obdevel/Pico-hardware/IMG_0175.JPG

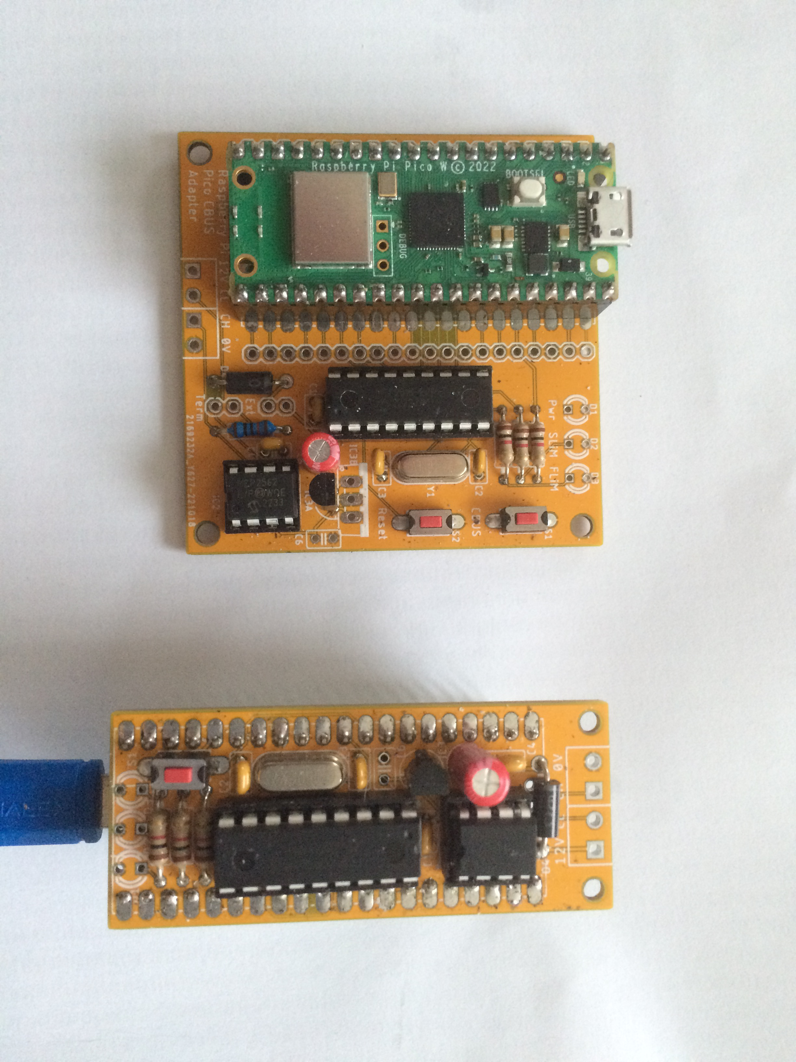
IMG_0175.JPG
