obdevel/Pico-hardware/CBUS Pico TH adapter rev A.png

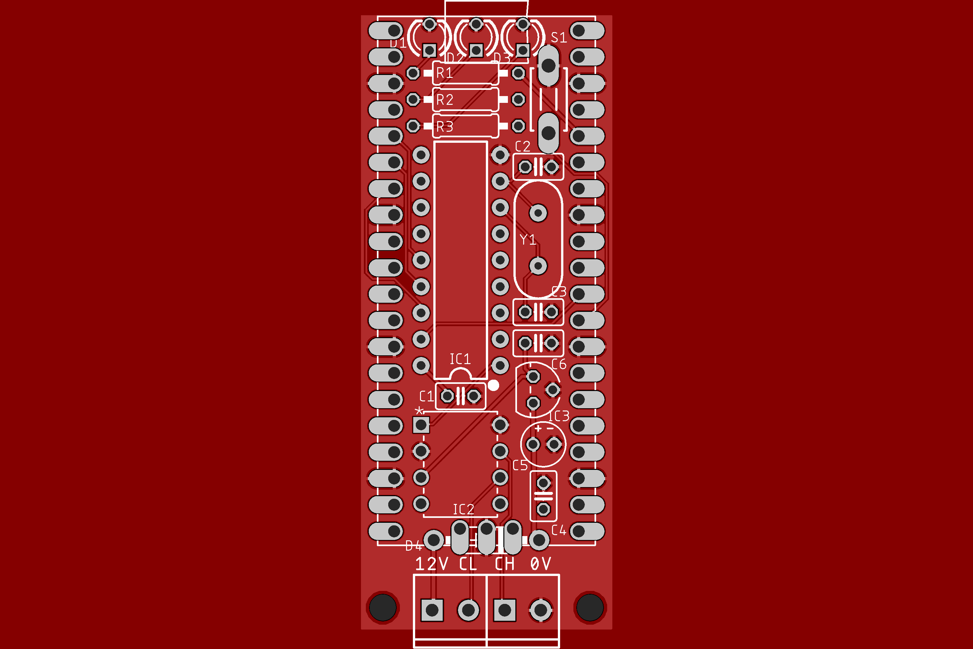
CBUS Pico TH adapter rev A.png
