obdevel/Pico-hardware/CBUS Pico TH adapter rev A.pdf

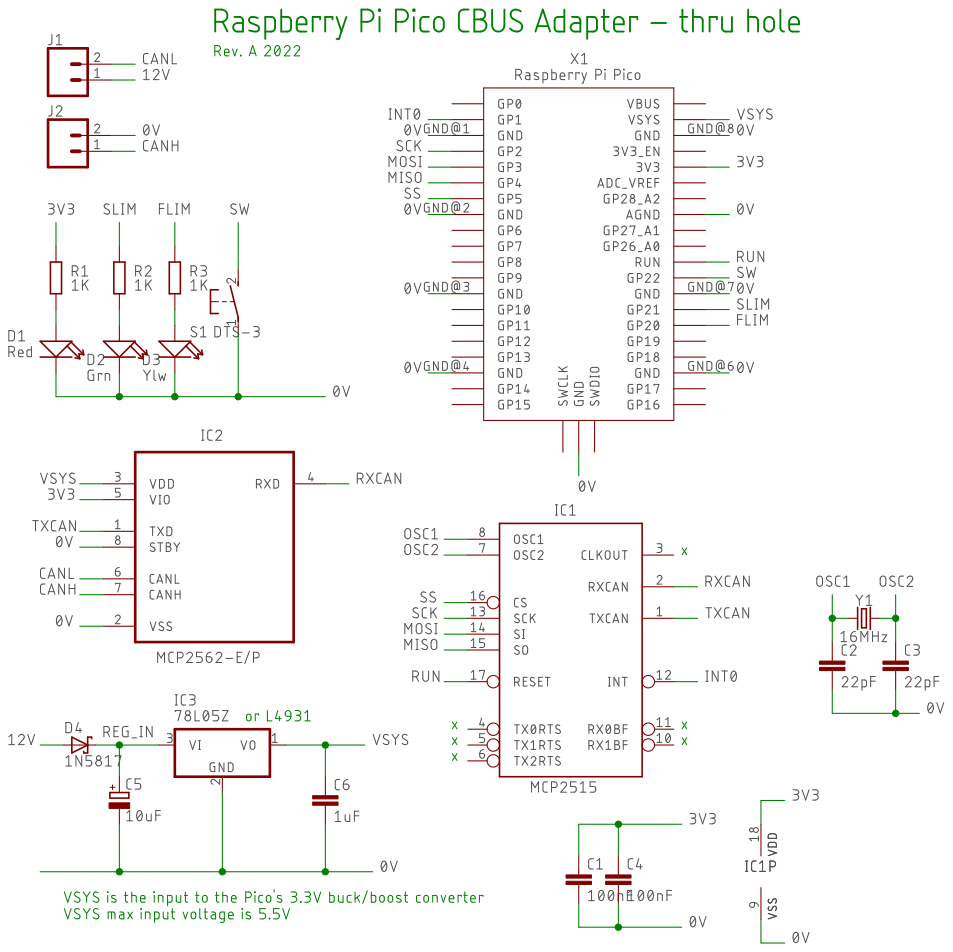
[picture p3: page 1]
