obdevel/Pico-hardware/CBUS Pico TH carrier w headers rev A.pdf

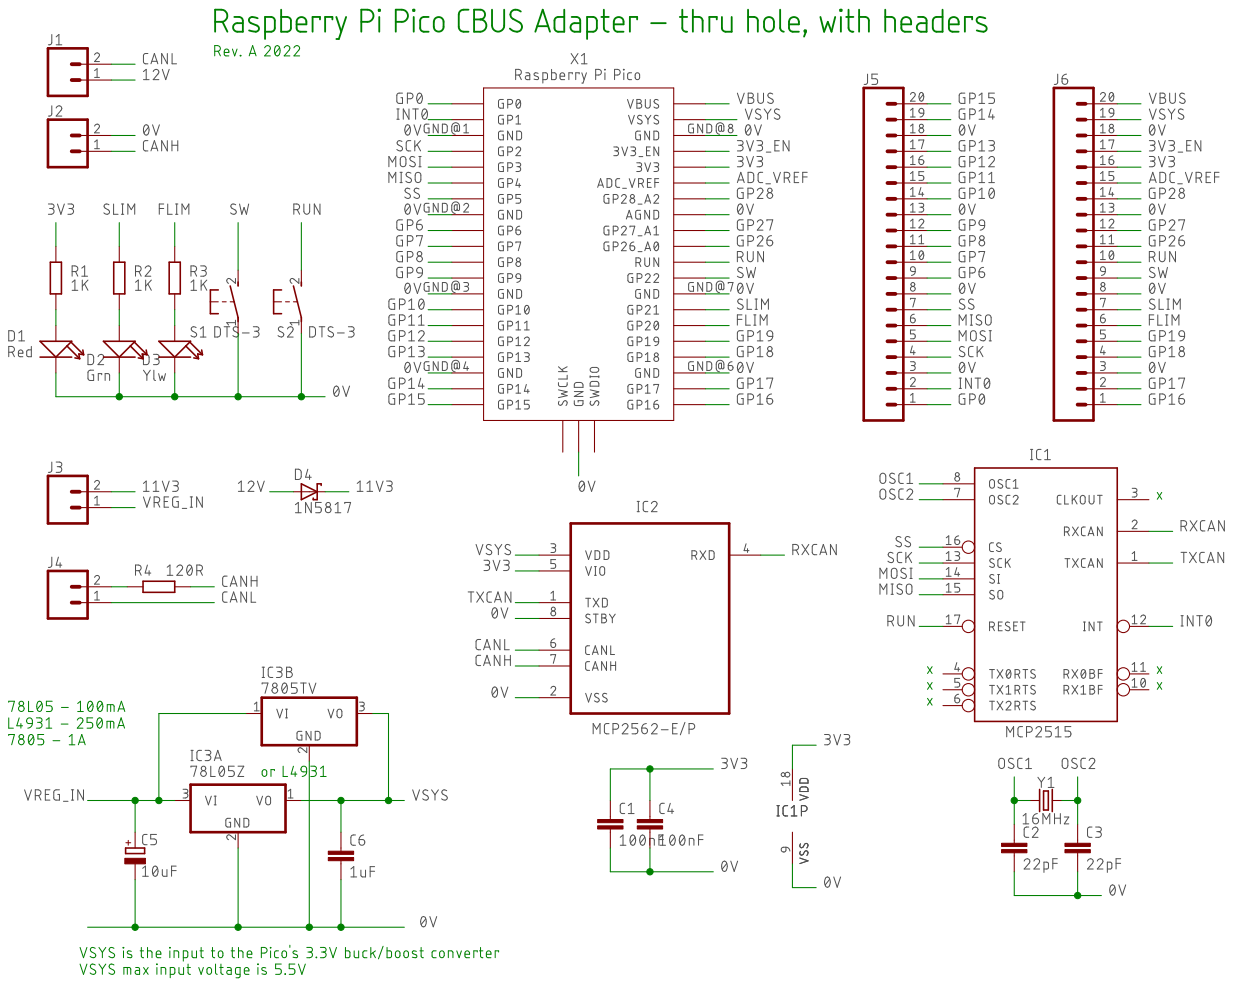
[picture p4: page 1]
