obdevel/Pico-hardware/CBUS Pico TH adapter rev A.brd

## EAGLE design CBUS Pico TH adapter rev A.brd (2023-01-14)

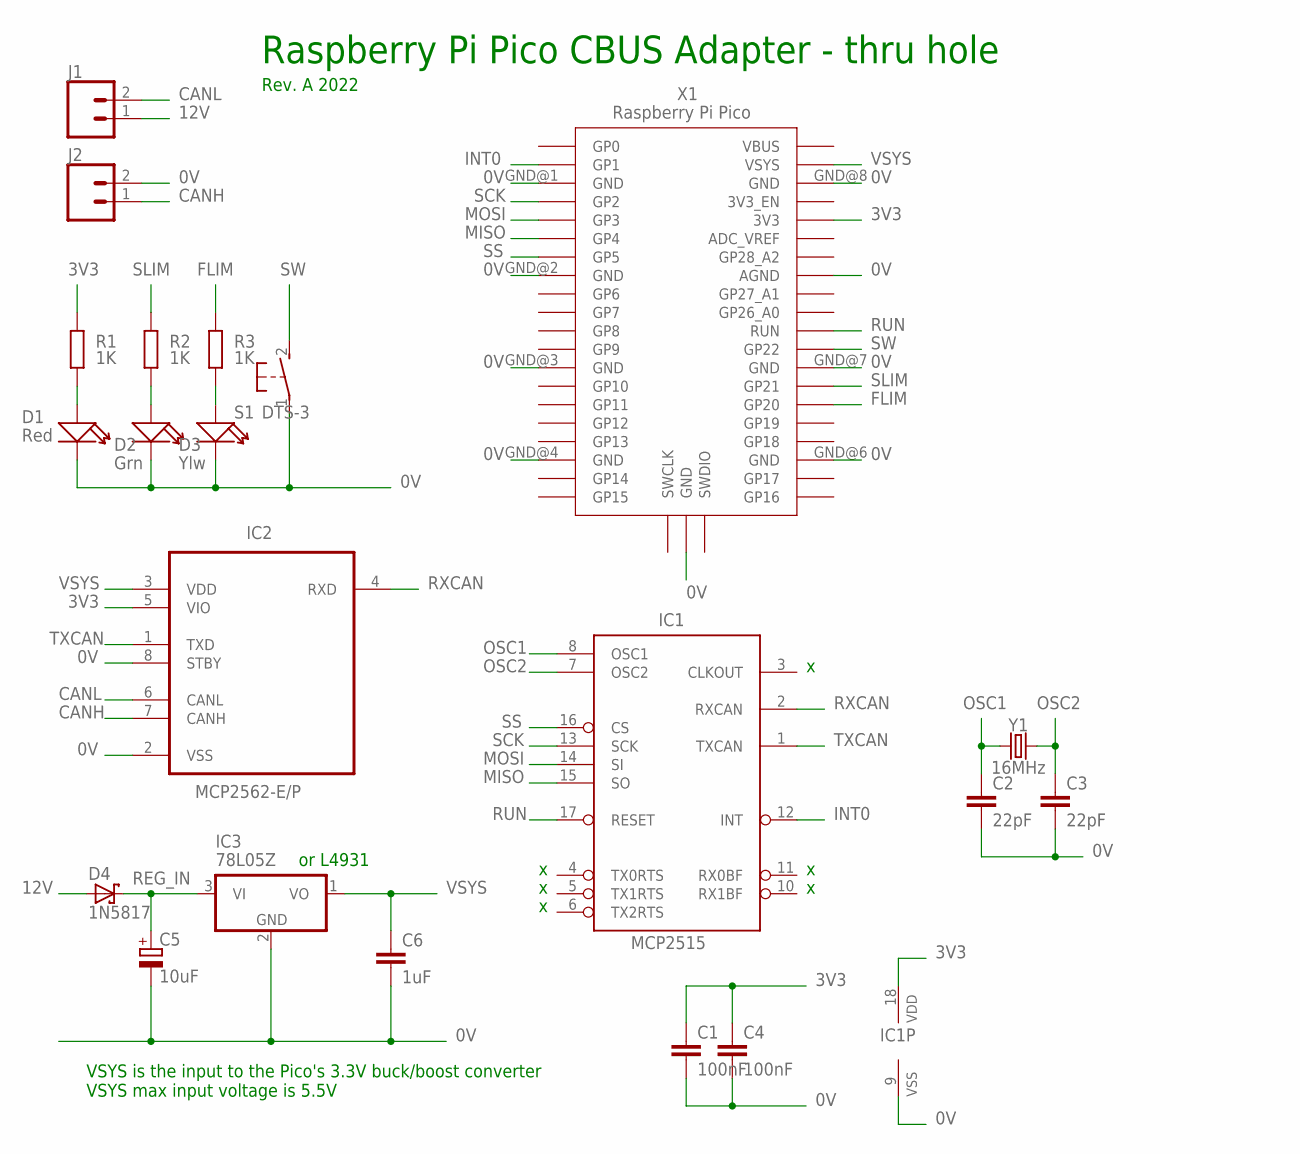
[picture p5: schematic CBUS Pico TH adapter rev A.sch]

Parts:
C1, C4: 100nF; C025-025X050
C2, C3: 22pF; C025-025X050
C5: 10uF; E2-4
C6: 1uF; C025-025X050
D1: Red; LED2-2.54-D3.0MM
D2: Grn; LED2-2.54-D3.0MM
D3: Ylw; LED2-2.54-D3.0MM
D4: 1N5817; DO41-10
IC1: MCP2515; DIP18
IC2: MCP2562-E/P; DIP254P762X533-8
IC3: 78L05Z; TO92
J1, J2: CONN_023.5MM; SCREWTERMINAL-3.5MM-2
R1, R2, R3: 1K; 0207/10
S1: DTS-3
X1: Raspberry Pi Pico; RPI_PICO_TH
Y1: 16MHz; HC49US

Connections:
0V: C1.2, C2.2, C3.2, C4.2, C5.-, C6.2, D1.K (-), D2.K (-), D3.K (-), IC1.9 (VSS), IC2.2 (VSS), IC2.8 (STBY), IC3.2 (GND), J2.2, S1.1, X1.AGND, X1.GND@1 (GND), X1.GND@2 (GND), X1.GND@3 (GND), X1.GND@4 (GND), X1.GND@5 (GND), X1.GND@6 (GND), X1.GND@7 (GND), X1.GND@8 (GND)
3V3: C1.1, C4.1, IC1.18 (VDD), IC2.5 (VIO), R1.1, X1.3V3
12V: D4.A, J1.1
CANH: IC2.7 (CANH), J2.1
CANL: IC2.6 (CANL), J1.2
FLIM: R3.1, X1.GP20
INT0: IC1.12 (INT), X1.GP1
MISO: IC1.15 (SO), X1.GP4
MOSI: IC1.14 (SI), X1.GP3
unnamed: D1.A (+), R1.2
unnamed: D2.A (+), R2.2
unnamed: D3.A (+), R3.2
OSC1: C2.1, IC1.8 (OSC1), Y1.1
OSC2: C3.1, IC1.7 (OSC2), Y1.2
REG_IN: C5.+, D4.C, IC3.3 (VI)
RUN: IC1.17 (RESET), X1.RUN
RXCAN: IC1.2 (RXCAN), IC2.4 (RXD)
SCK: IC1.13 (SCK), X1.GP2
SLIM: R2.1, X1.GP21
SS: IC1.16 (CS), X1.GP5
SW: S1.2, X1.GP22
TXCAN: IC1.1 (TXCAN), IC2.1 (TXD)
VSYS: C6.1, IC2.3 (VDD), IC3.1 (VO), X1.VSYS

Notes on the sheet:
Raspberry Pi Pico CBUS Adapter - thru hole
Rev. A 2022
VSYS is the input to the Pico's 3.3V buck/boost converter VSYS max input voltage is 5.5V
or L4931

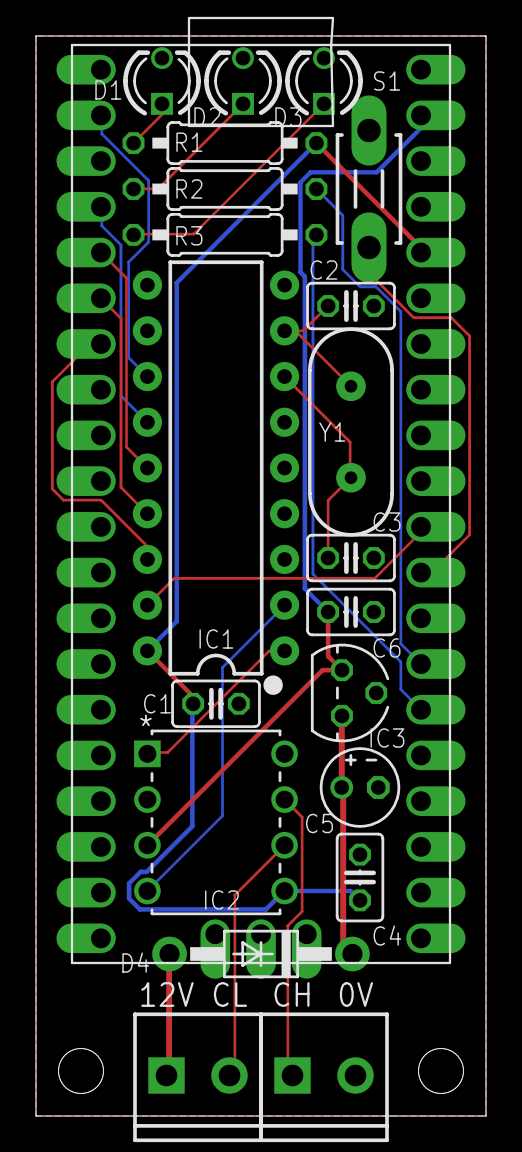
[picture p6: board CBUS Pico TH adapter rev A.brd from above]

Board: 2 copper layers, 25.0 x 60.0 mm, 21 parts (0 on the bottom side), 23 nets.
